Andrew-Collins/crkbd/corne-optical/pcb/plate.FCStd

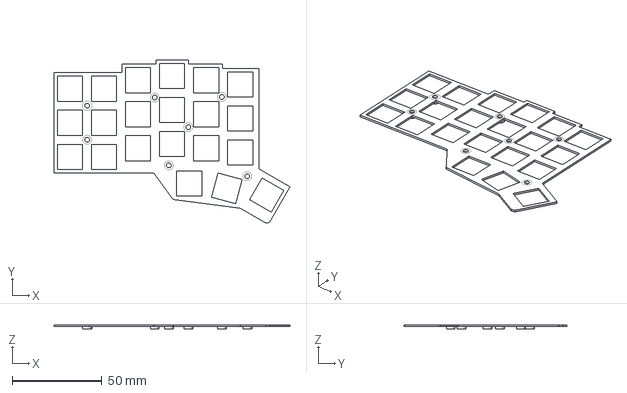
[picture p1: CAD file, 2022-08-25]
corne-optical/pcb/plate.FCStd
131.8 x 91.2 x 2.50 mm
