Andrew-Collins/crkbd/corne-optical/pcb/plate_press.FCStd

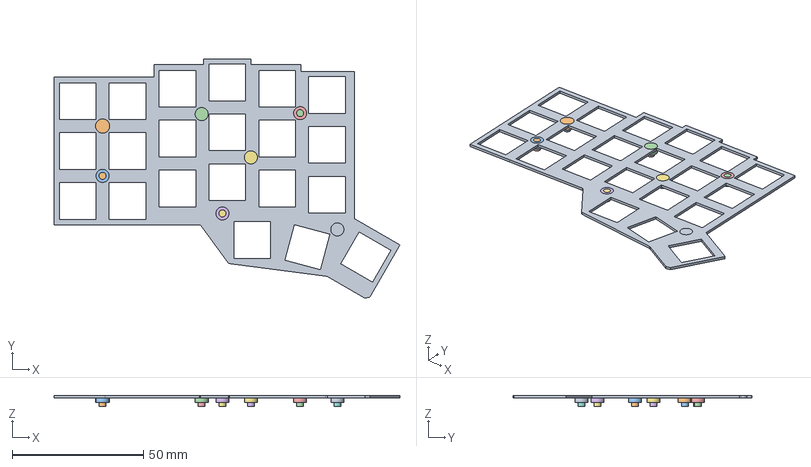
[picture p2: CAD file, 2022-08-25]
corne-optical/pcb/plate_press.FCStd
131.8 x 91.2 x 4.20 mm
