Andrew-Collins/crkbd/corne-optical/pcb/corne-optical.kicad_pcb

## KiCad design corne-optical/pcb/corne-optical.kicad_pcb (2022-08-21)

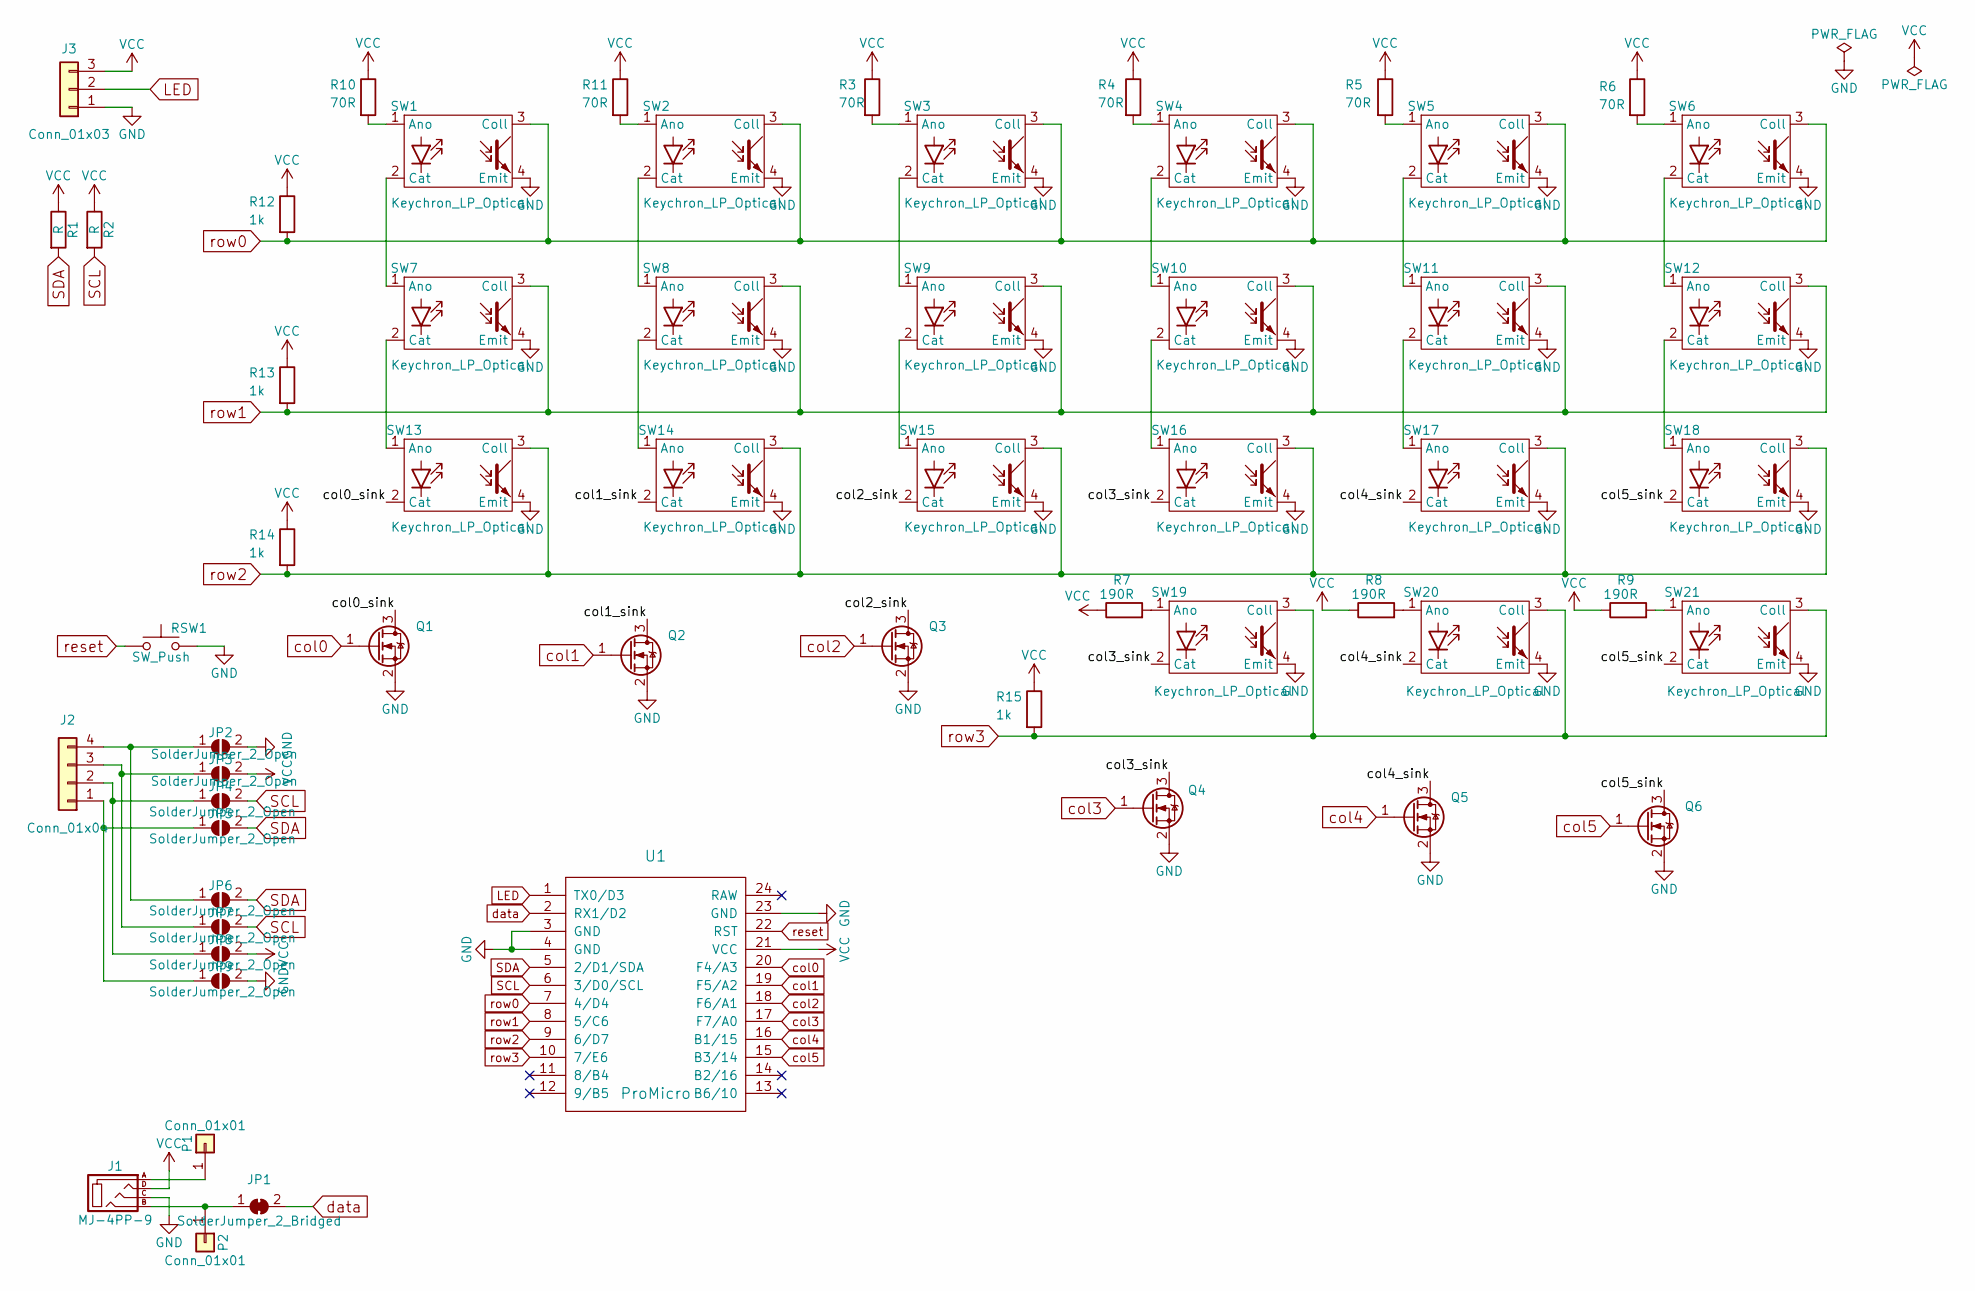
[picture p3: schematic corne-optical.kicad_sch, Corne Optical]

Parts:
J1: MJ-4PP-9
J2: Conn_01x04; OLED
J3: Conn_01x03; StripLED_rev
JP1: SolderJumper_2_Bridged; Jumper
JP2, JP3, JP4, JP5, JP6, JP7, JP8, JP9: SolderJumper_2_Open; Jumper
P1, P2: Conn_01x01; 1pin_conn
Q1, Q2, Q3, Q4, Q5, Q6: Q_NMOS_GSD; SOT-23
R1, R2: R; R_0603_1608Metric
R3, R4, R5, R6, R10, R11: 70R; R_0603_1608Metric
R7, R8, R9: 190R; R_0603_1608Metric
R12, R13, R14, R15: 1k; R_0603_1608Metric
RSW1: SW_Push; ResetSW
SW1, SW2, SW3, SW4, SW5, SW6, SW7, SW8, SW9, SW10, SW11, SW12, SW13, SW14, SW15, SW16, SW17, SW18, SW19, SW20: Keychron_LP_Optical
SW21: Keychron_LP_Optical; Keychron_LP_Optical_1.5u
U1: ProMicro; ProMicro_v2

Connections:
/col0_sink: Q1.3 (D), SW13.2 (Cat)
/col1_sink: Q2.3 (D), SW14.2 (Cat)
/col2_sink: Q3.3 (D), SW15.2 (Cat)
/col3_sink: Q4.3 (D), SW16.2 (Cat), SW19.2 (Cat)
/col4_sink: Q5.3 (D), SW17.2 (Cat), SW20.2 (Cat)
/col5_sink: Q6.3 (D), SW18.2 (Cat), SW21.2 (Cat)
GND: J1.C, J3.1, JP2.2 (B), JP9.2 (B), Q1.2 (S), Q2.2 (S), Q3.2 (S), Q4.2 (S), Q5.2 (S), Q6.2 (S), RSW1.2, SW1.4 (Emit), SW2.4 (Emit), SW3.4 (Emit), SW4.4 (Emit), SW5.4 (Emit), SW6.4 (Emit), SW7.4 (Emit), SW8.4 (Emit), SW9.4 (Emit), SW10.4 (Emit), SW11.4 (Emit), SW12.4 (Emit), SW13.4 (Emit), SW14.4 (Emit), SW15.4 (Emit), SW16.4 (Emit), SW17.4 (Emit), SW18.4 (Emit), SW19.4 (Emit), SW20.4 (Emit), SW21.4 (Emit), U1.3 (GND), U1.4 (GND), U1.23 (GND)
LED: J3.2, U1.1 (TX0/D3)
unnamed: J1.A, P1.1
unnamed: J1.B, JP1.1 (A), P2.1
unnamed: J2.1, JP5.1 (A), JP9.1 (A)
unnamed: J2.2, JP4.1 (A), JP8.1 (A)
unnamed: J2.3, JP3.1 (A), JP7.1 (A)
unnamed: J2.4, JP2.1 (A), JP6.1 (A)
unnamed: R3.2, SW3.1 (Ano)
unnamed: R4.2, SW4.1 (Ano)
unnamed: R5.2, SW5.1 (Ano)
unnamed: R6.2, SW6.1 (Ano)
unnamed: R7.2, SW19.1 (Ano)
unnamed: R8.2, SW20.1 (Ano)
unnamed: R9.2, SW21.1 (Ano)
unnamed: R10.2, SW1.1 (Ano)
unnamed: R11.2, SW2.1 (Ano)
unnamed: SW1.2 (Cat), SW7.1 (Ano)
unnamed: SW2.2 (Cat), SW8.1 (Ano)
unnamed: SW3.2 (Cat), SW9.1 (Ano)
unnamed: SW4.2 (Cat), SW10.1 (Ano)
unnamed: SW10.2 (Cat), SW16.1 (Ano)
unnamed: SW5.2 (Cat), SW11.1 (Ano)
unnamed: SW11.2 (Cat), SW17.1 (Ano)
unnamed: SW6.2 (Cat), SW12.1 (Ano)
unnamed: SW12.2 (Cat), SW18.1 (Ano)
unnamed: SW7.2 (Cat), SW13.1 (Ano)
unnamed: SW8.2 (Cat), SW14.1 (Ano)
unnamed: SW9.2 (Cat), SW15.1 (Ano)
SCL: JP4.2 (B), JP7.2 (B), R2.2, U1.6 (3/D0/SCL)
SDA: JP5.2 (B), JP6.2 (B), R1.2, U1.5 (2/D1/SDA)
VCC: J1.D, J3.3, JP3.2 (B), JP8.2 (B), R1.1, R2.1, R3.1, R4.1, R5.1, R6.1, R7.1, R8.1, R9.1, R10.1, R11.1, R12.1, R13.1, R14.1, R15.1, U1.21 (VCC)
col0: Q1.1 (G), U1.20 (F4/A3)
col1: Q2.1 (G), U1.19 (F5/A2)
col2: Q3.1 (G), U1.18 (F6/A1)
col3: Q4.1 (G), U1.17 (F7/A0)
col4: Q5.1 (G), U1.16 (B1/15)
col5: Q6.1 (G), U1.15 (B3/14)
data: JP1.2 (B), U1.2 (RX1/D2)
reset: RSW1.1, U1.22 (RST)
row0: R12.2, SW1.3 (Coll), SW2.3 (Coll), SW3.3 (Coll), SW4.3 (Coll), SW5.3 (Coll), SW6.3 (Coll), U1.7 (4/D4)
row1: R13.2, SW7.3 (Coll), SW8.3 (Coll), SW9.3 (Coll), SW10.3 (Coll), SW11.3 (Coll), SW12.3 (Coll), U1.8 (5/C6)
row2: R14.2, SW13.3 (Coll), SW14.3 (Coll), SW15.3 (Coll), SW16.3 (Coll), SW17.3 (Coll), SW18.3 (Coll), U1.9 (6/D7)
row3: R15.2, SW19.3 (Coll), SW20.3 (Coll), SW21.3 (Coll), U1.10 (7/E6)

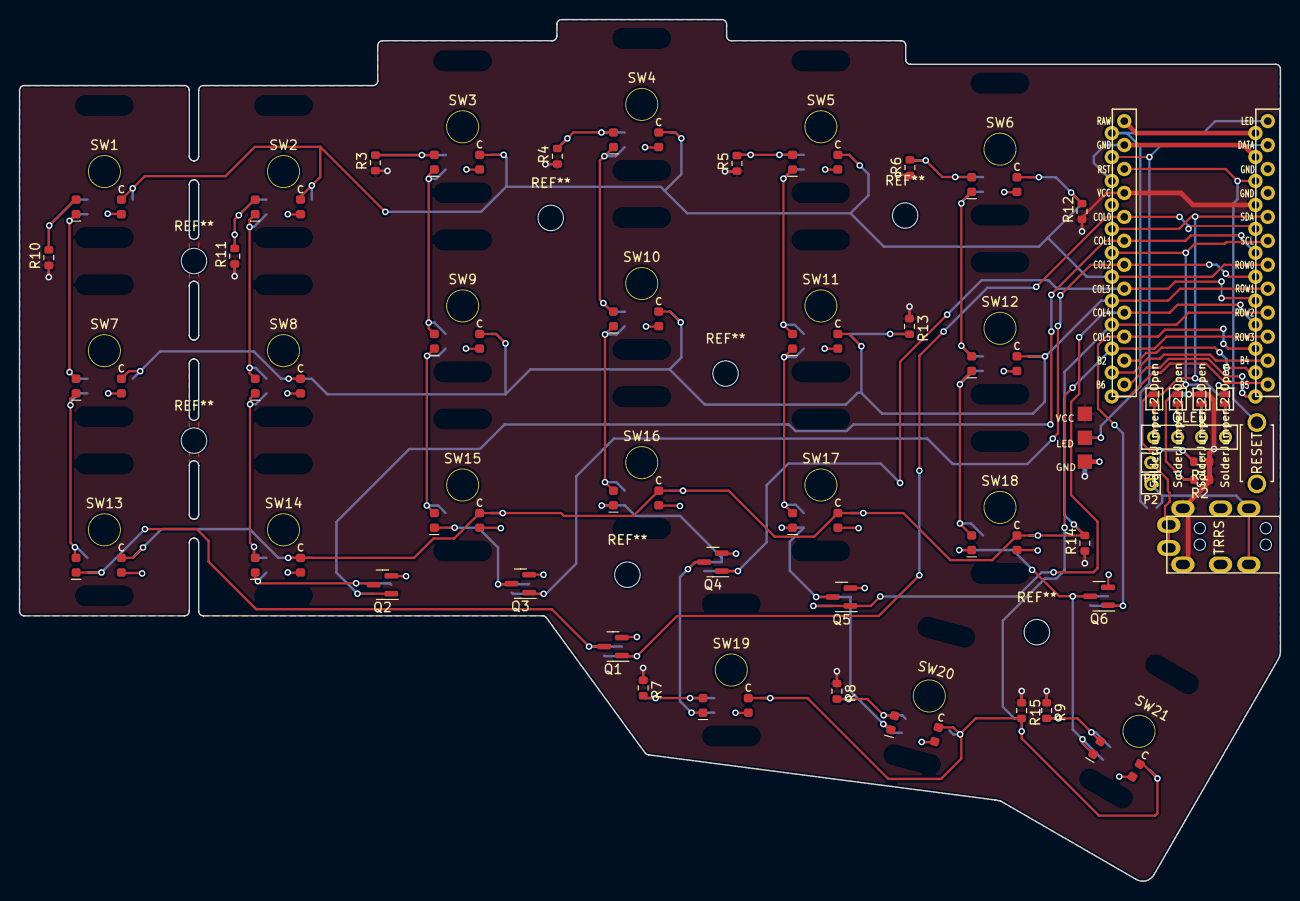
[picture p4: board corne-optical.kicad_pcb from above]

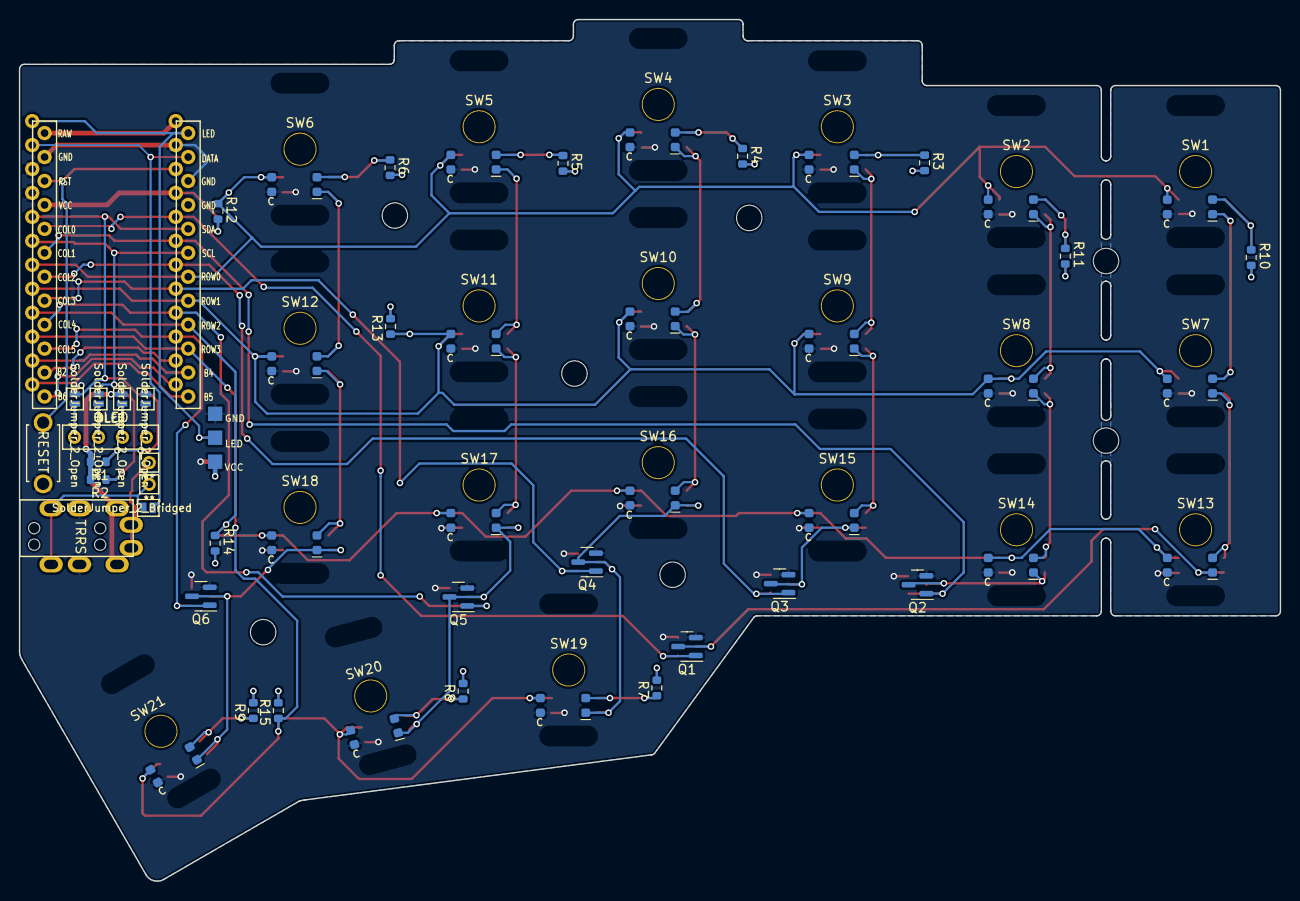
[picture p5: board corne-optical.kicad_pcb from below]

Board: 2 copper layers, 133.8 x 91.4 mm, 58 parts (5 on the bottom side), 50 nets.
