Andrew-Collins/crkbd/corne-chocolate/pcb/corne-chocolate.kicad_sch

## KiCad design corne-chocolate/pcb/corne-chocolate.kicad_sch (2022-07-31)

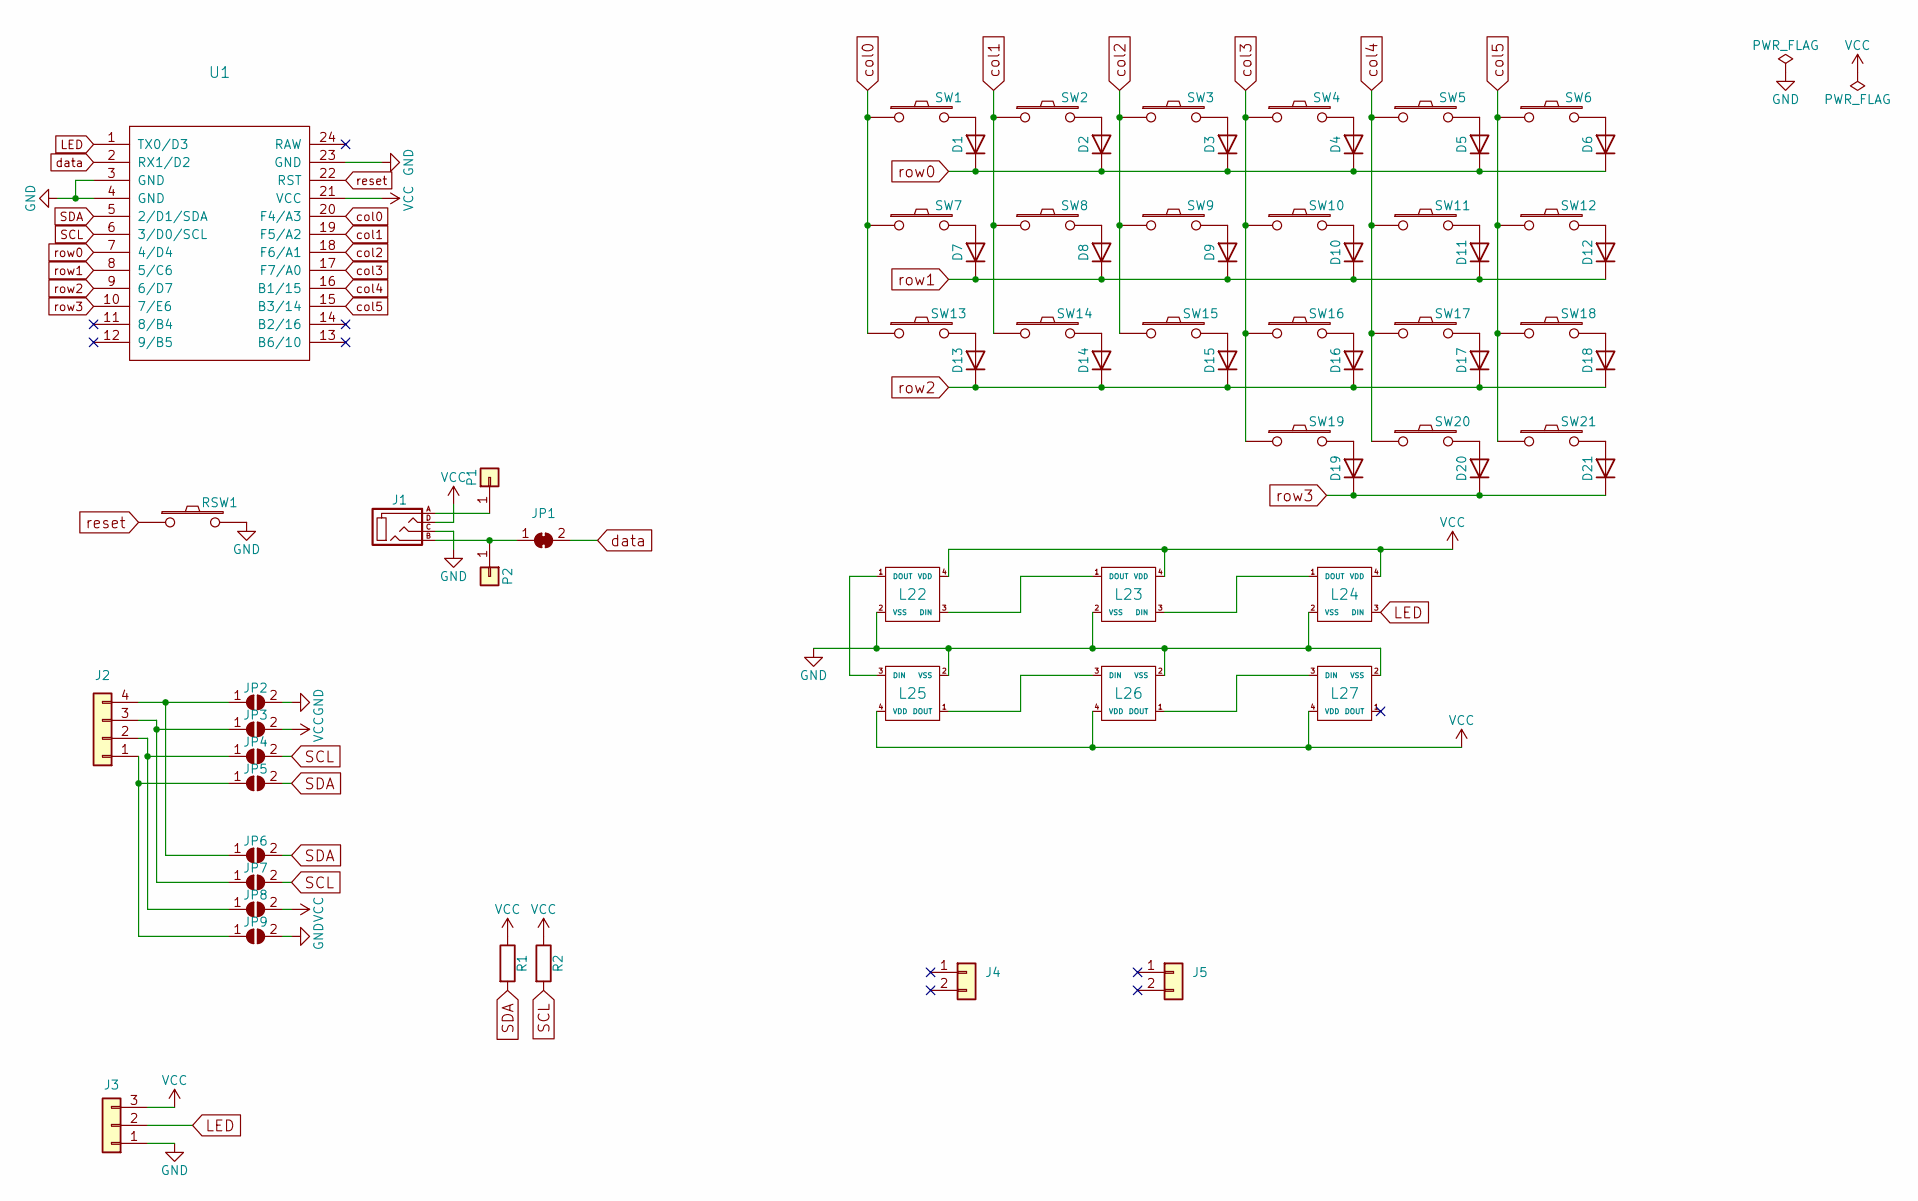
[picture p6: schematic corne-chocolate.kicad_sch]

Parts:
D1, D2, D3, D4, D5, D6, D7, D8, D9, D10, D11, D12, D13, D14, D15, D16, D17, D18, D19, D20, D21: (no value)
J1, J2, J3, J4, J5: (no value)
JP1, JP2, JP3, JP4, JP5, JP6, JP7, JP8, JP9: (no value)
L22, L23, L24, L25, L26, L27: (no value)
P1, P2: (no value)
R1, R2: (no value)
RSW1: (no value)
SW1, SW2, SW3, SW4, SW5, SW6, SW7, SW8, SW9, SW10, SW11, SW12, SW13, SW14, SW15, SW16, SW17, SW18, SW19, SW20, SW21: (no value)
U1: (no value)

Connections:
GND: J1.C, J3.1, JP2.2 (B), JP9.2 (B), L22.2 (VSS), L23.2 (VSS), L24.2 (VSS), L25.2 (VSS), L26.2 (VSS), L27.2 (VSS), RSW1.2, U1.3 (GND), U1.4 (GND), U1.23 (GND)
LED: J3.2, L24.3 (DIN), U1.1 (TX0/D3)
unnamed: D1.2 (A), SW1.2
unnamed: D2.2 (A), SW2.2
unnamed: D3.2 (A), SW3.2
unnamed: D4.2 (A), SW4.2
unnamed: D5.2 (A), SW5.2
unnamed: D6.2 (A), SW6.2
unnamed: D7.2 (A), SW7.2
unnamed: D8.2 (A), SW8.2
unnamed: D9.2 (A), SW9.2
unnamed: D10.2 (A), SW10.2
unnamed: D11.2 (A), SW11.2
unnamed: D12.2 (A), SW12.2
unnamed: D13.2 (A), SW13.2
unnamed: D14.2 (A), SW14.2
unnamed: D15.2 (A), SW15.2
unnamed: D16.2 (A), SW16.2
unnamed: D17.2 (A), SW17.2
unnamed: D18.2 (A), SW18.2
unnamed: D19.2 (A), SW19.2
unnamed: D20.2 (A), SW20.2
unnamed: D21.2 (A), SW21.2
unnamed: J1.A, P1.1
unnamed: J1.B, JP1.1 (A), P2.1
unnamed: J2.1, JP5.1 (A), JP9.1 (A)
unnamed: J2.2, JP4.1 (A), JP8.1 (A)
unnamed: J2.3, JP3.1 (A), JP7.1 (A)
unnamed: J2.4, JP2.1 (A), JP6.1 (A)
unnamed: L22.1 (DOUT), L25.3 (DIN)
unnamed: L22.3 (DIN), L23.1 (DOUT)
unnamed: L23.3 (DIN), L24.1 (DOUT)
unnamed: L25.1 (DOUT), L26.3 (DIN)
unnamed: L26.1 (DOUT), L27.3 (DIN)
SCL: JP4.2 (B), JP7.2 (B), R2.2, U1.6 (3/D0/SCL)
SDA: JP5.2 (B), JP6.2 (B), R1.2, U1.5 (2/D1/SDA)
VCC: J1.D, J3.3, JP3.2 (B), JP8.2 (B), L22.4 (VDD), L23.4 (VDD), L24.4 (VDD), L25.4 (VDD), L26.4 (VDD), L27.4 (VDD), R1.1, R2.1, U1.21 (VCC)
col0: SW1.1, SW7.1, SW13.1, U1.20 (F4/A3)
col1: SW2.1, SW8.1, SW14.1, U1.19 (F5/A2)
col2: SW3.1, SW9.1, SW15.1, U1.18 (F6/A1)
col3: SW4.1, SW10.1, SW16.1, SW19.1, U1.17 (F7/A0)
col4: SW5.1, SW11.1, SW17.1, SW20.1, U1.16 (B1/15)
col5: SW6.1, SW12.1, SW18.1, SW21.1, U1.15 (B3/14)
data: JP1.2 (B), U1.2 (RX1/D2)
reset: RSW1.1, U1.22 (RST)
row0: D1.1 (K), D2.1 (K), D3.1 (K), D4.1 (K), D5.1 (K), D6.1 (K), U1.7 (4/D4)
row1: D7.1 (K), D8.1 (K), D9.1 (K), D10.1 (K), D11.1 (K), D12.1 (K), U1.8 (5/C6)
row2: D13.1 (K), D14.1 (K), D15.1 (K), D16.1 (K), D17.1 (K), D18.1 (K), U1.9 (6/D7)
row3: D19.1 (K), D20.1 (K), D21.1 (K), U1.10 (7/E6)
