Andrew-Collins/crkbd/corne-optical/doc/buildguide_jp.md

# Build Guide

こちらは Corne Chocolate のビルドガイドになります。
[Corne Cherry はこちら](https://github.com/foostan/crkbd/blob/master/corne-cherry/doc/buildguide_jp.md)。

## 部品

### 必須

| 名前 | 数 | 備考 |
|:-|:-|:-|
| PCB | 2枚 | |
| トッププレート | 2枚 | |
| ボトムプレート | 2枚 | PCBタイプとアクリルタイプが選べます |
| ProMicro保護プレート | 2枚 | |
| ProMicro | 2枚 | |
| TRRSジャック | 2個 | |
| タクトスイッチ | 2個 | |
| ダイオード | 42本 | チップ部品のみに対応 |
| Kailh PCBソケット(Choc用) | 42個 | |
| キースイッチ | 42個 | Chocにのみ対応 |
| キーキャップ | 42個 | 1u 40個、1.5u 2個 |
| OLEDモジュール | 2枚 | |
| ピンヘッダ 4連 | 2つ | |
| ピンソケット4連 | 2つ | |
| スペーサー M2 4.5mm | 10本 | |
| スペーサー M2 9mm | 4本 | |
| ネジ M2 4mm | 28本 | |
| クッションゴム | 8個 | |
| TRS(3極)ケーブル | 1本 | TRRS(4極)ケーブルでも可 |
| Micro USBケーブル | 1本 | |

### オプション

| 名前 | 数 | 備考 |
|:-|:-|:-|
| SK6812MINI | 54個 | 上向き実装 42個、下向き実装 12個 |

## 事前準備

ファームウェアを自分でビルドする場合は環境を整備するのに時間がかかるのではじめに取り掛かっておくことをおすすめします。\
詳しくは <https://github.com/foostan/crkbd/blob/master/doc/firmware_jp.md> を参照してください。

## 実装

PCBはリバーシブルになっているので、最初にどちらを左用/右用にするか決めます。



### ダイオード

チップ部品のダイオードのはんだづけを行います。
Corne Cherryではどちらの面に取り付けるかは自由でしたが、Corne Chocolateでは**必ず裏面に取り付けてください**。
表面に実装するとトッププレートと干渉してしまいます。

チップ部品は非常に小さいためピンセット及び逆作用ピンセットがあると作業がしやすくなります。
**ダイオードは取り付ける向きが決まっている**ので、次の写真のように予め取り付ける列と行を揃えて配置しておくとスムーズに進められます。



ダイオードの向きは次のとおりです。チップ部品の「|||」印が、ダイオードマーク「|◁」の「|」の方に向けるように取り付けます(画像はCorne Cherryから転記)。



チップ部品を取り付けるコツですが、まずは予備ハンダとしてパッドの右側のみにハンダを盛ります。



次に予備ハンダを溶かすようにしてダイオードの片足をはんだ付けします。
このとき、逆作用ピンセットを利用すると力を入れずともチップ部品をしっかりと持つことができ、位置合わせとはんだづけに集中できるのでおすすめです。
またはんだごてがあつすぎたり、はんだを触りすぎたりするとはんだに含まれるフラックスが気化してきれいにはんだの山ができることがありますが、あとで修復できるのでこの時点ではパーツを付けることだけを意識すれば大丈夫です。



次にもう片方をはんだづけします。少量のはんだで十分なのでつけすぎに注意します。
つけすぎてしまった場合は吸い取り線で取るか、はんだごてですくうようにすれば取れます。



また予備はんだ側のはんだの量が少ない場合は追加ではんだづけを重ねて行い、山になっている場合はフラックスを上から塗って熱すればきれいになります。



### TRRSジャック、リセットスイッチ、ピンソケット



下記の写真通りにTRRSジャック、リセットスイッチ、ピンソケットをPCBの**表面にはんだづけします**。
ダイオードを裏側につけているので、その反対側の面になります。



### OLEDモジュールのためのジャンパ

OLEDモジュールを利用する場合は下記のようにジャンパします。
なお**表面のみジャンパしてください**。



ジャンパがうまくいかない場合はおそらくはんだの量が少ないか、はんだに含まれるフラックスが気化してしまっています。
その場合は、はんだを多めに使うか、別途フラックスを塗るとうまくジャンパができます。

### ProMicro



ピンヘッダを白い枠に当てはめるようにはんだづけし、そこにProMicroの裏面を上にしてはんだづけします。




なおスプリングピンヘッダを利用する場合は [Helix のビルドガイド](https://github.com/MakotoKurauchi/helix/blob/master/Doc/buildguide_jp.md#pro-micro)を参考にしてください。

### OLEDモジュール



OLED用のピンソケットにピンヘッダを先に差し込み、その後からピンヘッダとOLEDモジュールをはんだづけします。
このときOLEDモジュールが浮きやすいので指で押さえつけながら浮かないように気をつけます。




### 動作確認

ProMicroとOLEDモジュールを付けた段階で動作確認をすることをおすすめします(一番最後にやると問題の切り分けが難しくなる)。

動作確認をする場合は先に下記の「ファームウェア」の章を参考にしてcrkbd用のファームウェアをProMicroに入れてください（必ず両側に入れてください）。

動作確認は左手側はMicroUSBでPCとつなぎ、左手側と右手側をTRSケーブルで接続させて行います。ジャック等の不良等もありえるので、片方ずつではなく必ず左右を接続させてから動作確認をしてください。ここまで正しくできていれば、PCBソケットを取り付けるパッドをピンセット等でショートさせるとOLEDモジュールに押されたキーが表示されます。



## LED（オプション）



SK6812MINIを取り付けていきます。
なお、LEDの取り付けは完成後からでも行えるので、実装が心配な方はこの章を飛ばして、まずは完成させることをおすすめします。

SK6812MINIは非常に熱に弱く、簡単に壊れます。
温調機能がついたはんだごてを利用し、220℃ ~ 270℃ぐらいの温度で作業することをおすすめします。
また温度を調整しても長い時間コテをLEDに当てていると破損するので、なるべくすばやくはんだづけすることを心がけます。
LEDは４つずつはんだづけを行いますが、一度に４つ行わず、２つずつ行ってLEDの温度の上昇を防ぐと破損しづらくなるのでおすすめです。

まずは取り付ける位置の確認です。

1 ~ 6は裏面側(Undergrow)が光るようにし、7 ~ 27は表側（Backlight）が光るようにはんだづけを行います。下記がLEDを取り付ける位置です(画像はCorne Cherryから転記)。




1 ~ 6 は下記のように丸印で囲った黒い部分を下にしたとき、矢印で示したシルクの目印が上になるようにはんだづけを行います。
1 ~ 3 と 4 ~ 5 で向きが変わるので注意してください。



7 ~ 27 は下記のように、丸印で囲った一番大きなパッドと、矢印で示したシルクの目印が隣り合うようにはんだづけを行います。



すべて正常にはんだづけができれば下記のように光ります。
もし途中までしか光らない場合は数字の順番でLEDがつながっているので、光らないLEDもしくはその前のLEDのはんだづけミスやLEDの破損を疑ってください。





### Kailh PCBソケット



裏面の両側のパッドにはんだを盛ります。後から追加するのが難しいので予め多めに盛ってください。



ソケットをはめこみ、持ったはんだを溶かすようにして取り付けます。
このときソケットが浮かないようにピンセットや指で押さえつけながら行います。



はんだづけはこれで完了です。




### プレート、スイッチ



トッププレートとボトムプレート用のスペーサーは4.5mm、OLED用のスペーサーは9mmを使用します。



なおプレートの側面を黒のマジックで塗りつぶすと見栄えが良くなるのでおすすめです。



## ファームウェア

下記を参照しファームウェアをProMicroに書き込みます。\
<https://github.com/foostan/crkbd/blob/master/doc/firmware_jp.md>

以上で完成です。
