Andrew-Collins/crkbd/(commit log)

2022-07-31 chocolate ready to go with extra connectors for travelling
    [corne-chocolate.kicad_pcb, corne-chocolate.kicad_sch, corne-chocolate.sch]
2022-07-31 Optical schematic done
    [corne-optical.kicad_pcb, corne-optical.kicad_sch]
2022-07-31 Fixed up designators on optical
    [corne-optical.kicad_sch]
2022-07-31 Missed a few
    [corne-optical.kicad_sch]
2022-07-31 Trying to workout phantom copper
    [corne-optical.kicad_pcb, corne-optical.kicad_sch]
2022-08-03 Fixed outline, just trying to solve switch footprint glitch
    [corne-optical.kicad_pcb, corne-optical.kicad_sch]
2022-08-07 Finished, but need to add mounting holes for plate
    [corne-optical.kicad_pcb, corne-optical.kicad_sch]
2022-08-21 Holes done and board sent off
    [corne-optical.kicad_pcb]
2022-08-25 Added plates
    [plate.FCStd, plate_press.FCStd]
